ciruitbuilder/Rotating-Mirror-LIDAR-using-a-Time-of-Flight-Sensor/LIDAR_images/cover image.jpeg

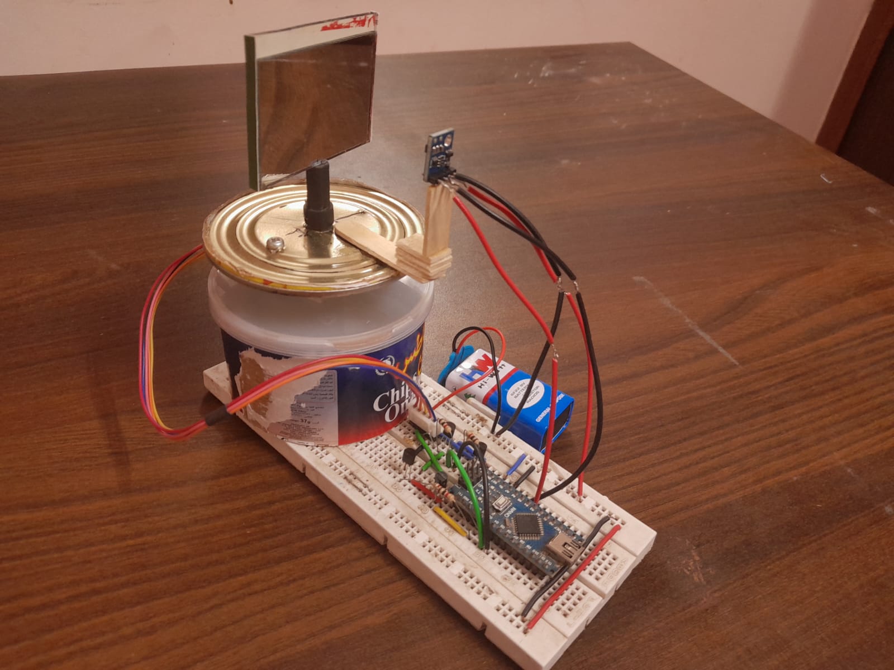
LIDAR_images/cover image.jpeg
