ciruitbuilder/Rotating-Mirror-LIDAR-using-a-Time-of-Flight-Sensor/README.md

# Rotating-Mirror-LIDAR-using-a-Time-of-Flight-Sensor
cover image

DESCRIPTION:

This is an attempt to build a LIDAR(Light Ditection and Ranging) using a GY-VL53L0X Time of FLight(ToF) sensor and a unipolar stepper motor. 

BUILD:

The build involves a rotating set of mirrors placed so that its centre aligns with the ToF sensor's laser emitter and photo avalanche diode array reciever.
The element responsible with the rotation of the mirror is a unipolar stepper motor. The whole setup is placed over a tin plate.

The unipolar stepper motor driver was built by me using an array of NPN transistors and turning them on and off in order using an arduino board(same one used to gather distance data from the ToF sensor)

The stepper motor is powered by the 9v battery and the arduino is powered by a usb cable connected to the laptop.

MATERIALS REQUIRED:

28byj 48 12v unipolar stepper motor

GY-VL53L0X ToF Sensor

Pair of mirrors stuck together(on the non reflective sides) to create a reflective surface on both sides for reflection to allow the reflected ray cover all of 2D area when the mirror rotates.

Wires

4x BC547 NPN Transistor

9v HW battery

Popsicle sticks(to support the ToF sensor).

2x Screws

CIRCUIT DIAGRAM:

LIDAR circuit

RAY OPTICS:

Visulizing how the diverging beam of IR from the VL53L0X sensor hits the mirror, gets reflected and keeps diverging.
image 1



image 2



graph link:

https://www.desmos.com/3d/aw1s0kakht

The diverging beam of transmitter IR(looks like a cone) is incident on the mirror which makes an angle with the axis of the cone ,with vertex angle of 25 degrees, but i'm using 35 degrees as recommended by the VL53L0X datasheet for less interference in reading. This incident cone creates a ellipse of light rays in the plane of mirror.



ellipse:



this angle is used to decide the distance at which we need to keep the mirror from the sensor and which ultimately for a fixed size of mirror decides the un measurable lost region due to the sensor hiding the reflected transmitted beam.

The beam keeps diverging even after reflection, it is because the reflected rays diverge away(see images 1 and 2 made by me in desmos3d for visualization)

calculation of distance between ToF sensor and centre of mirror:

radius finding

Visualization of LIDAR scanning full 360 degrees:

LIDAR 360 scan visualization

link: https://www.desmos.com/3d/27ven6rfr8

The reflected ray doesnt make the same angle with the x axis as the plane makes at any point of time, derivation of relation between the angle made by reflected ray with x axis to the angle made by plane with x axis:

angle relation lidar

x -> angle made by mirror with y axis = angle made by normal with x axis.

as x = θ, using the diagram in above image, angle made by reflected ray with x axis(in image, +x axis is pointing downwards, towards sensor/source) is twice that of angle made by the normal with x axis : angle of reflected ray with x axis = 2x

Hence for a 360 degree scan, the mirror has to rotate only by 180 degrees per sweep.

CODE AND WORKING OF LIDAR:

configuration of VL53L0X, input output pins and Serial monitor has been done in void setup.

The code for this project has five functions:

1. get_distance() ---> measures and returns the sum, distance between the LIDAR mirror + distance between mirror and TOF sensor. Return value is an unsigned int

2. fwd() ----> runs the for loop to turn on transistor array for the stepper motor to step forward.the loop itself consist of 4 steps per loop. Returns none, gets int as number of steps

3. bwd() ----> runs loop for backward stepper spin. Returns none, gets number of steps.

4. set_low() ----> sets all stepper motor transistor array pins low.

5. stepper() ---- > combines fwd() and bwd().  updates a count to keep track of number of times 4 seps has been taken(for angle calculation).
   the count is used int calculating angle by multiplying the ratio of number of 4 steps taken to number of 4 steps in a full 360 degree spin(2048 steps in full rotation) = 2048/4 = 512 sets of 4 steps, ratio : (count/512). multiplying ratio with 2*pi will give the angle at that point of time in radians

Void loop calls these functions in order of :
1. getting the distance
2. calculating the coordinates
3. printing coordinates to serial monitor
4. moving the stepper 4 steps forward
5. waiting 300ms.

OUTPUT:

I tested the LIDAR by placing it in front of a flat wall and inside closed walls. To visualze surrounding of lidar the x and y coordinates are printed into the serial monitor, i copied those values into a notepad file and saved it in a .xyz format. This .xyz file is uploaded into xyzviewer website : https://www.xyzviewer.com/

The images for flatwall and closed square walls can be found inside the output_images section in this project repository. The curved look of flat walls is due to the conical nature of the incident and reflected beam, when a beam is incident at a point of time, the sensor takes the average of all those returning distances(for each ray), hence causing the curvature. 

also we can see the points converge into the LIDAR's position where we expect two other edges of the box(see box in output_images). This is due to the physical obstruction of reflected due to the placement of sensor(obstructs the area behind it and hence points converge near it) for one edge, and reflection of ray from the non reflective side of the mirror in short distances, hiding the other edge

non reflective side

VIDEO OF LIDAR SCANNING(SHOT USING IR CAMERA MADE BY ME BY REMOVING IR FILTER FROM AN OLD WEBCAM, VIDEO IS IN 2X SPEED):

https://github.com/user-attachments/assets/cbd07f28-aee5-4edc-a908-0589862b54cc

DISADVANTAGES:

1. Sensor gives points arranged in a curve while scanning thoug a wall(exoected: straight line).
2. Loss of coverage due to physical obstruction by ToF sensor and non reflective part of mirror.
3. readings are taken once in 4 steps of stepper motor, limiting resolution.

problems i encountered : in the first run of this project(this is the second run), i tried using a mirror wayy smaller than this(1.3cm side length) which is fit for a smaller radius design and more compact. but the readings were way less accurate and erroraneous, so i use a bgger mirrors to accomodate the rays fully inside the reflective surface. 

END:

This is an effort by me to make a LIDAR using affordable sensors, motors and household materials. Though it doesnt give outputs equivalent to a costly LIDAR, It still gives identifiable and useful information about its surroundings.

THANK YOU
