ciruitbuilder/Rotating-Mirror-LIDAR-using-a-Time-of-Flight-Sensor/output_images/flatwall result.png

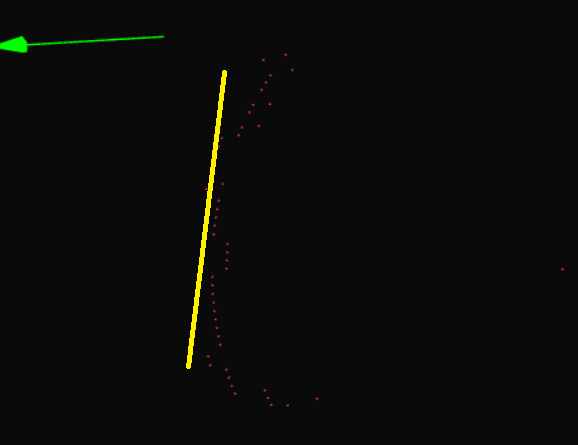
output_images/flatwall result.png
