ciruitbuilder/Rotating-Mirror-LIDAR-using-a-Time-of-Flight-Sensor/output_images/square wall result 2.png

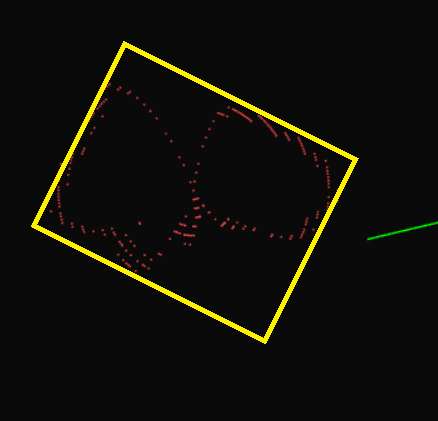
output_images/square wall result 2.png
