ciruitbuilder/Rotating-Mirror-LIDAR-using-a-Time-of-Flight-Sensor/(commit log)

2026-07-22 Add files via upload
    This video is shot using a IR camera thats was made by modifying an old webcam by removing its infrared filter and letting it see the IR beam incident on the surface the LIDAR is scanning
2026-07-22 Add files via upload
    This video is shot on a IR camera , which is a old webcam whose IR filter is removed(modified by me)
